lhr-solar/DataAcq-SunlightPCB/Telemetry-PrimaryPCB.pdf

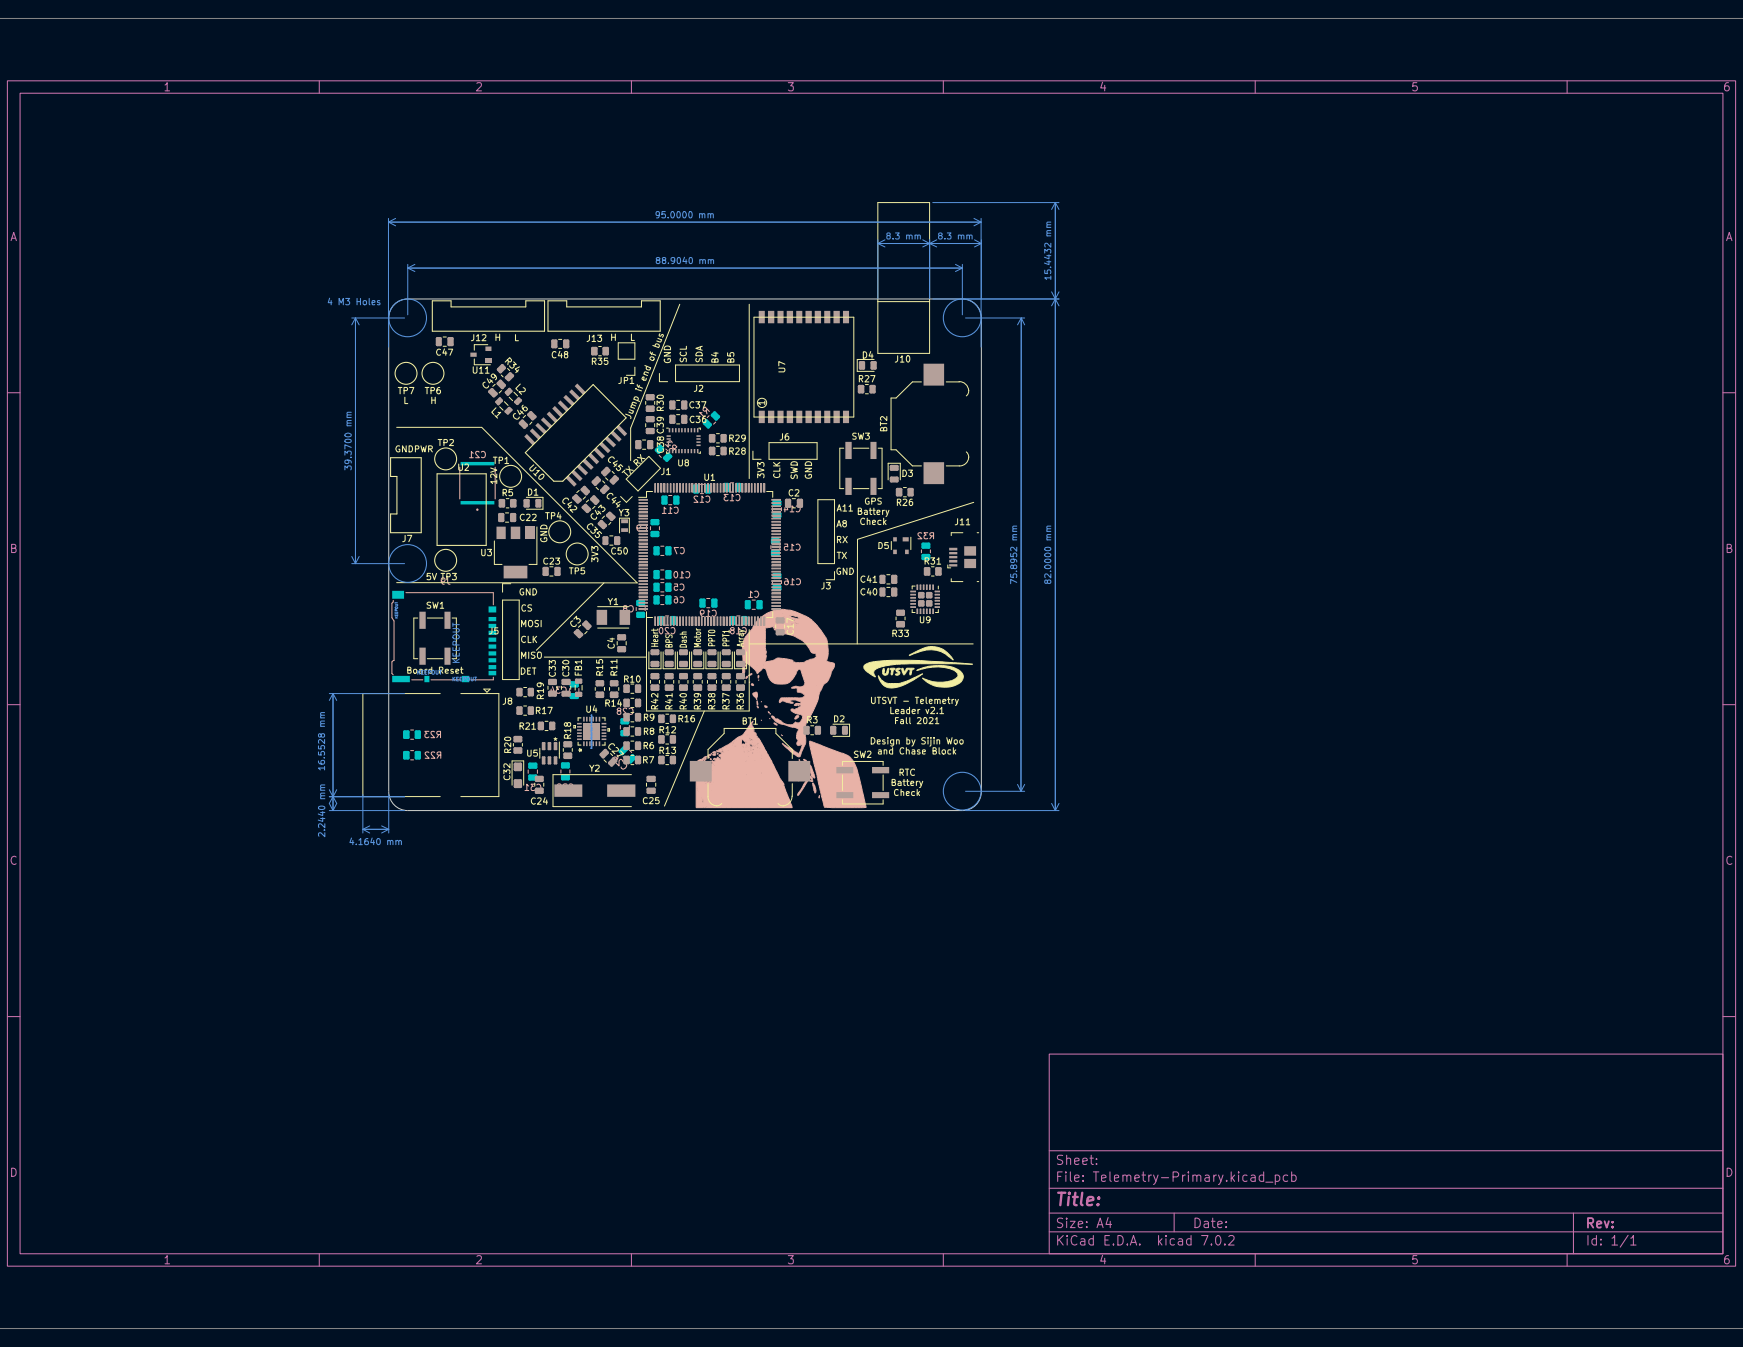
[picture p2: page 1]
