lhr-solar/DataAcq-SunlightPCB/Telemetry-Primary.kicad_pcb

## KiCad design Telemetry-Primary.kicad_pcb (2023-06-17)

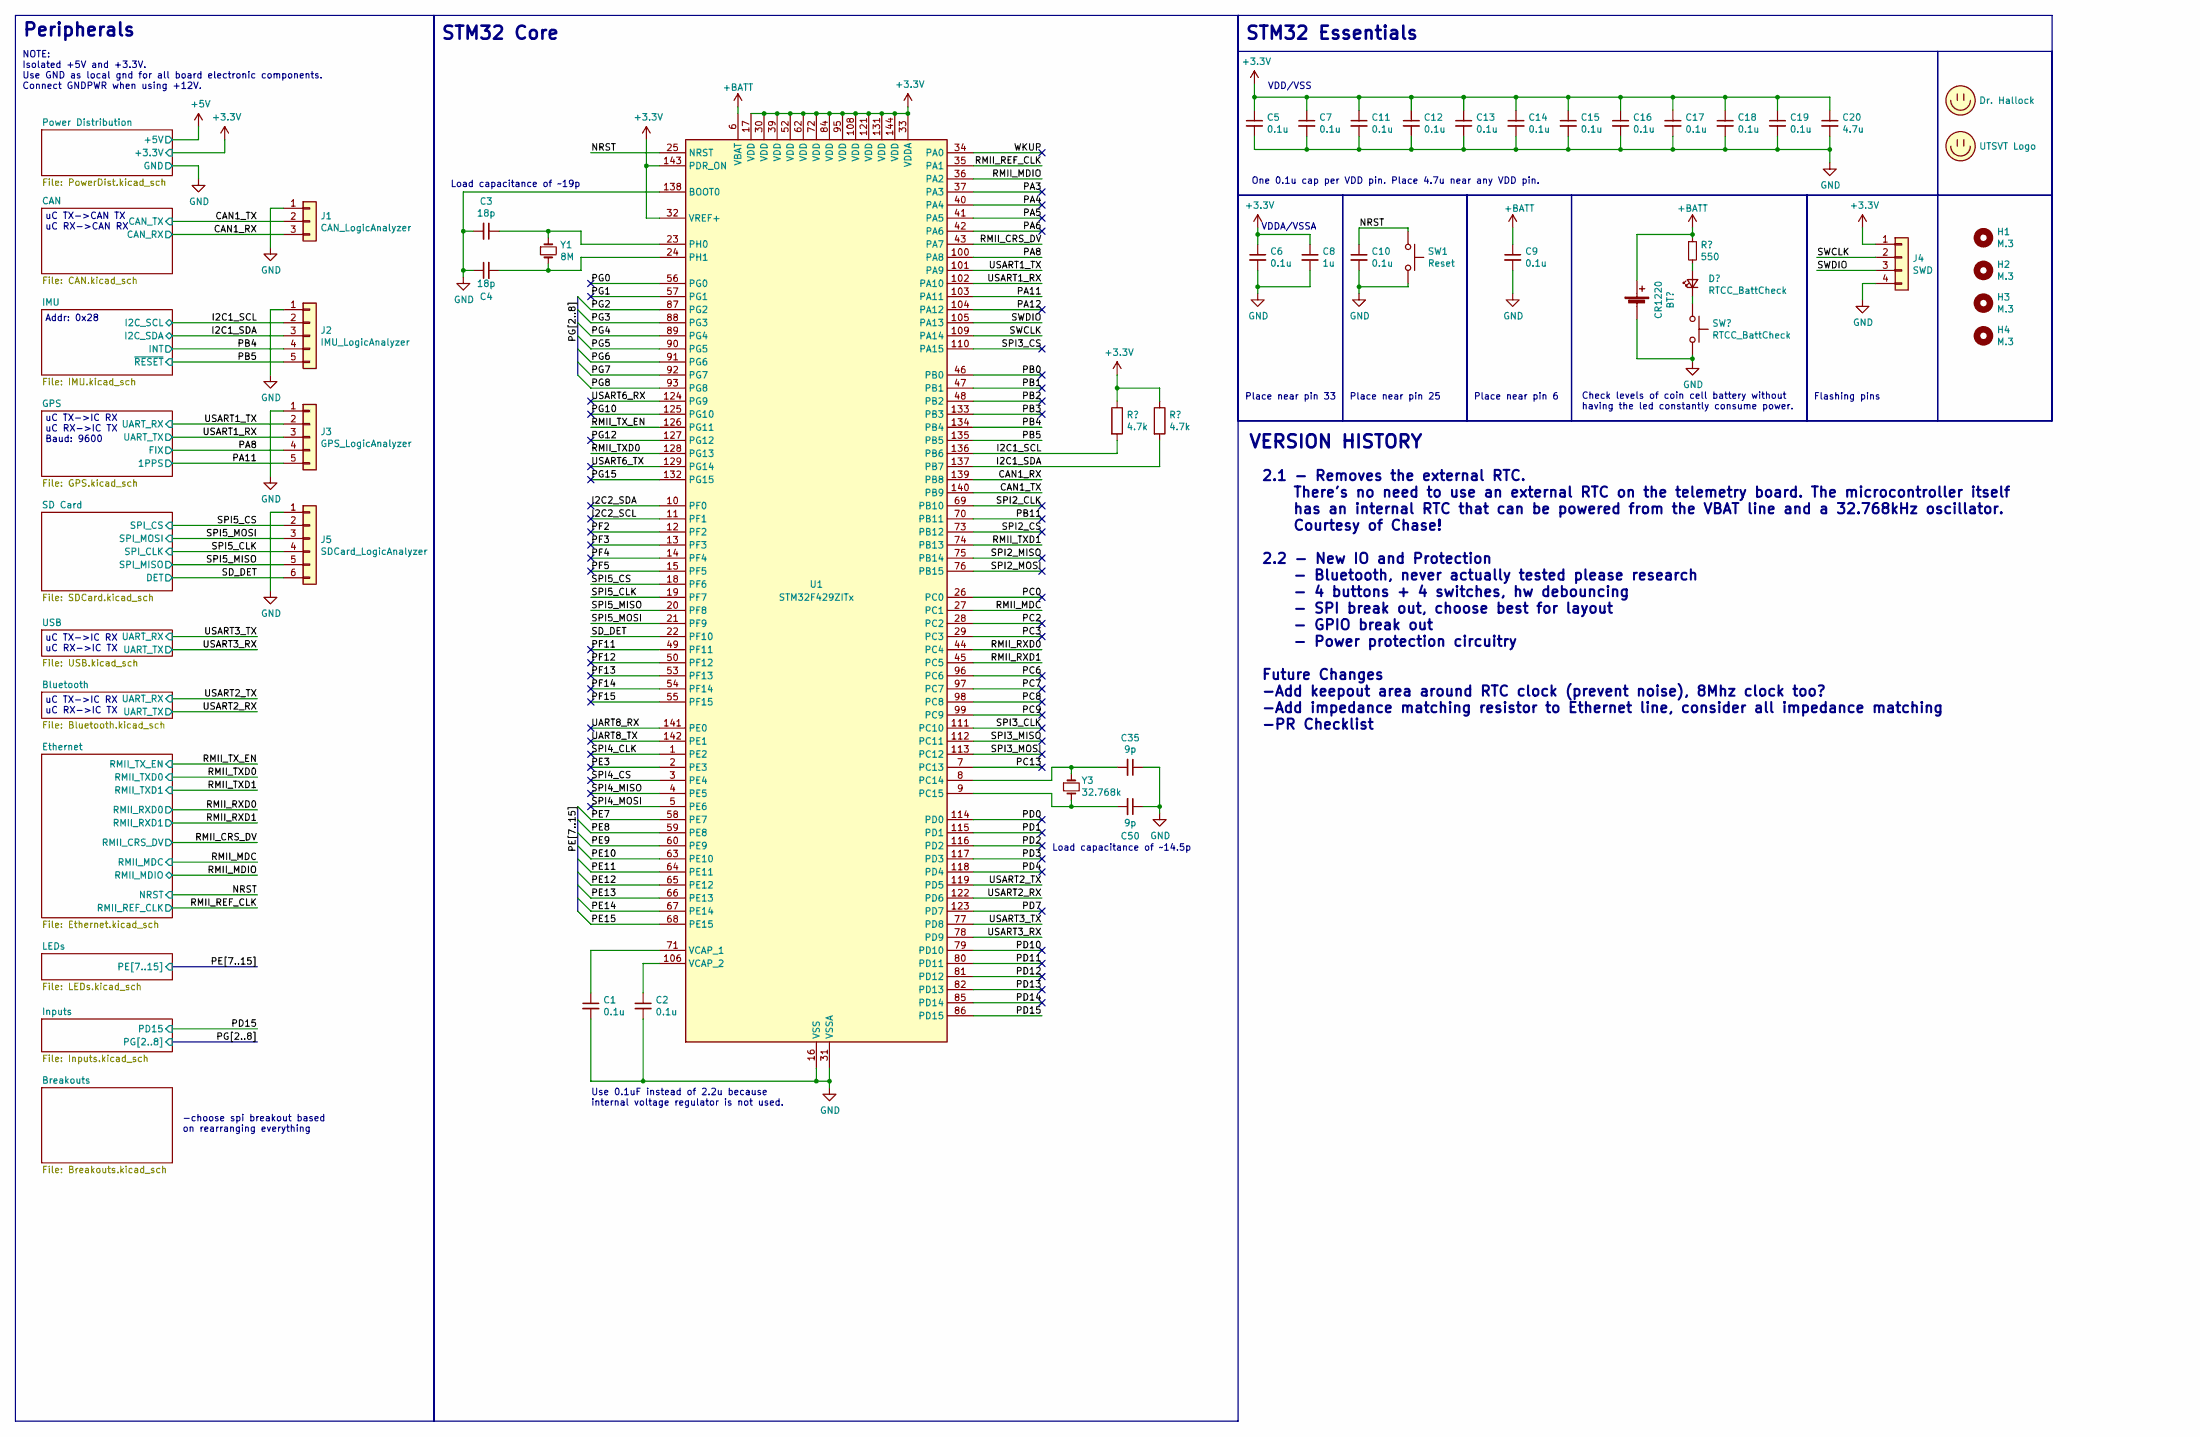
[picture p12: schematic Telemetry-Primary.kicad_sch]

Parts:
BT1: CR1220; BatteryHolder_Keystone_3000_1x12mm
C1, C2, C5, C6, C7, C9, C10, C11, C12, C13, C14, C15, C16, C17, C18, C19: 0.1u; C_0805_2012Metric
C3, C4: 18p; C_0805_2012Metric
C8: 1u; C_0805_2012Metric
C20: 4.7u; C_0805_2012Metric
C35, C50: 9p; C_0805_2012Metric
D2: RTCC_BattCheck; LED_0805_2012Metric
H1, H2, H3, H4: M.3; MountingHole_3mm
J1: CAN_LogicAnalyzer; PinHeader_1x03_P2.54mm_Vertical
J2: IMU_LogicAnalyzer; PinHeader_1x05_P2.54mm_Vertical
J3: GPS_LogicAnalyzer; PinHeader_1x05_P2.54mm_Vertical
J4: SWD; PinHeader_1x04_P2.54mm_Vertical
J5: SDCard_LogicAnalyzer; PinHeader_1x06_P2.54mm_Vertical
LOGO1: Dr. Hallock; Hallock_Image
LOGO2: UTSVT Logo; UTSVT_Logo_Symbol
R1, R2: 4.7k; R_0805_2012Metric
R24: 550; R_0805_2012Metric
SW1: Reset; SW_SPST_B3SL-1002P
SW2: RTCC_BattCheck; SW_SPST_B3SL-1002P
U1: STM32F429ZITx; LQFP-144_20x20mm_P0.5mm
Y1: 8M; Crystal_SMD_TXC_7A-2Pin_5x3.2mm
Y3: 32.768k; Crystal_SMD_2012-2Pin_2.0x1.2mm

Connections:
+3.3V: C5.1, C6.1, C7.1, C8.1, C11.1, C12.1, C13.1, C14.1, C15.1, C16.1, C17.1, C18.1, C19.1, C20.1, J4.1, R1.1, R2.1, U1.17 (VDD), U1.30 (VDD), U1.32 (VREF+), U1.33 (VDDA), U1.39 (VDD), U1.52 (VDD), U1.62 (VDD), U1.72 (VDD), U1.84 (VDD), U1.95 (VDD), U1.108 (VDD), U1.121 (VDD), U1.131 (VDD), U1.143 (PDR_ON), U1.144 (VDD); also elsewhere on the board
/CAN1_RX: J1.3, U1.139 (PB8); also elsewhere on the board
/CAN1_TX: J1.2, U1.140 (PB9); also elsewhere on the board
/I2C1_SCL: J2.2, R1.2, U1.136 (PB6); also elsewhere on the board
/I2C1_SDA: J2.3, R2.2, U1.137 (PB7); also elsewhere on the board
/I2C2_SCL: U1.11 (PF1)
/I2C2_SDA: U1.10 (PF0)
/NRST: C10.1, SW1.1, U1.25 (NRST); also elsewhere on the board
/PA3: U1.37 (PA3)
/PA4: U1.40 (PA4)
/PA5: U1.41 (PA5)
/PA6: U1.42 (PA6)
/PA8: J3.4, U1.100 (PA8); also elsewhere on the board
/PA11: J3.5, U1.103 (PA11); also elsewhere on the board
/PA12: U1.104 (PA12)
/PB0: U1.46 (PB0)
/PB1: U1.47 (PB1)
/PB2: U1.48 (PB2)
/PB3: U1.133 (PB3)
/PB4: J2.4, U1.134 (PB4); also elsewhere on the board
/PB5: J2.5, U1.135 (PB5); also elsewhere on the board
/PB11: U1.70 (PB11)
/PC0: U1.26 (PC0)
/PC2: U1.28 (PC2)
/PC3: U1.29 (PC3)
/PC6: U1.96 (PC6)
/PC7: U1.97 (PC7)
/PC8: U1.98 (PC8)
/PC9: U1.99 (PC9)
/PC13: U1.7 (PC13)
/PD0: U1.114 (PD0)
/PD1: U1.115 (PD1)
/PD2: U1.116 (PD2)
/PD3: U1.117 (PD3)
/PD4: U1.118 (PD4)
/PD7: U1.123 (PD7)
/PD10: U1.79 (PD10)
/PD11: U1.80 (PD11)
/PD12: U1.81 (PD12)
/PD13: U1.82 (PD13)
/PD14: U1.85 (PD14)
/PD15: U1.86 (PD15)
/PE3: U1.2 (PE3)
/PE7: U1.58 (PE7); also elsewhere on the board
/PE8: U1.59 (PE8); also elsewhere on the board
/PE9: U1.60 (PE9); also elsewhere on the board
/PE10: U1.63 (PE10); also elsewhere on the board
/PE11: U1.64 (PE11); also elsewhere on the board
/PE12: U1.65 (PE12); also elsewhere on the board
/PE13: U1.66 (PE13); also elsewhere on the board
/PE14: U1.67 (PE14)
/PE15: U1.68 (PE15)
/PF2: U1.12 (PF2)
/PF3: U1.13 (PF3)
/PF4: U1.14 (PF4)
/PF5: U1.15 (PF5)
/PF11: U1.49 (PF11)
/PF12: U1.50 (PF12)
/PF13: U1.53 (PF13)
/PF14: U1.54 (PF14)
/PF15: U1.55 (PF15)
/PG0: U1.56 (PG0)
/PG1: U1.57 (PG1)
/PG2: U1.87 (PG2)
/PG3: U1.88 (PG3)
/PG4: U1.89 (PG4)
/PG5: U1.90 (PG5)
/PG6: U1.91 (PG6)
/PG7: U1.92 (PG7)
/PG8: U1.93 (PG8)
/PG10: U1.125 (PG10)
/PG12: U1.127 (PG12)
/PG15: U1.132 (PG15)
/RMII_CRS_DV: U1.43 (PA7); also elsewhere on the board
/RMII_MDC: U1.27 (PC1); also elsewhere on the board
/RMII_MDIO: U1.36 (PA2); also elsewhere on the board
/RMII_REF_CLK: U1.35 (PA1); also elsewhere on the board
/RMII_RXD0: U1.44 (PC4); also elsewhere on the board
/RMII_RXD1: U1.45 (PC5); also elsewhere on the board
/RMII_TXD0: U1.128 (PG13); also elsewhere on the board
/RMII_TXD1: U1.74 (PB13); also elsewhere on the board
/RMII_TX_EN: U1.126 (PG11); also elsewhere on the board
/SD_DET: J5.6, U1.22 (PF10); also elsewhere on the board
/SPI2_CLK: U1.69 (PB10)
/SPI2_CS: U1.73 (PB12)
/SPI2_MISO: U1.75 (PB14)
/SPI2_MOSI: U1.76 (PB15)
/SPI3_CLK: U1.111 (PC10)
/SPI3_CS: U1.110 (PA15)
/SPI3_MISO: U1.112 (PC11)
/SPI3_MOSI: U1.113 (PC12)
/SPI4_CLK: U1.1 (PE2)
/SPI4_CS: U1.3 (PE4)
/SPI4_MISO: U1.4 (PE5)
/SPI4_MOSI: U1.5 (PE6)
/SPI5_CLK: J5.4, U1.19 (PF7); also elsewhere on the board
/SPI5_CS: J5.2, U1.18 (PF6); also elsewhere on the board
/SPI5_MISO: J5.5, U1.20 (PF8); also elsewhere on the board
/SPI5_MOSI: J5.3, U1.21 (PF9); also elsewhere on the board
/UART8_RX: U1.141 (PE0)
/UART8_TX: U1.142 (PE1)
/USART1_RX: J3.3, U1.102 (PA10); also elsewhere on the board
/USART1_TX: J3.2, U1.101 (PA9); also elsewhere on the board
/USART2_RX: U1.122 (PD6); also elsewhere on the board
/USART2_TX: U1.119 (PD5); also elsewhere on the board
/USART3_RX: U1.78 (PD9); also elsewhere on the board
/USART3_TX: U1.77 (PD8); also elsewhere on the board
/USART6_RX: U1.124 (PG9)
/USART6_TX: U1.129 (PG14)
/WKUP: U1.34 (PA0)
GND: BT1.2 (-), C1.2, C2.2, C3.2, C4.1, C5.2, C6.2, C7.2, C8.2, C9.2, C10.2, C11.2, C12.2, C13.2, C14.2, C15.2, C16.2, C17.2, C18.2, C19.2, C20.2, C35.1, C50.1, J1.1, J2.1, J3.1, J4.4, J5.1, SW1.2, SW2.2, U1.16 (VSS), U1.31 (VSSA), U1.38 (VSS), U1.51 (VSS), U1.61 (VSS), U1.83 (VSS), U1.94 (VSS), U1.107 (VSS), U1.120 (VSS), U1.130 (VSS), U1.138 (BOOT0); also elsewhere on the board
unnamed: D2.1 (K), SW2.1
unnamed: C35.2, U1.8 (PC14), Y3.1
unnamed: C50.2, U1.9 (PC15), Y3.2
unnamed: C3.1, U1.23 (PH0), Y1.1
unnamed: C4.2, U1.24 (PH1), Y1.2
unnamed: C1.1, U1.71 (VCAP_1)
unnamed: C2.1, U1.106 (VCAP_2)

Notes on the sheet:
2.1 - Removes the external RTC. There's no need to use an external RTC on the telemetry board. The microcontroller itself has an internal RTC that can be powered from the VBAT line and a 32.768kHz oscillator. Courtesy of Chase! 2.2 - New IO and Protection - Bluetooth, never actually tested please r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
Place near pin 25
Load capacitance of ~19p
Place near pin 33
Addr: 0x28
VERSION HISTORY
NOTE: Isolated +5V and +3.3V. Use GND as local gnd for all board electronic components. Connect GNDPWR when using +12V.
STM32 Core
-choose spi breakout based on rearranging everything
Load capacitance of ~14.5p
uC TX->IC RX uC RX->IC TX Baud: 9600
Check levels of coin cell battery without having the led constantly consume power.
VDD/VSS
One 0.1u cap per VDD pin. Place 4.7u near any VDD pin.
Place near pin 6
Use 0.1uF instead of 2.2u because internal voltage regulator is not used.
uC TX->IC RX uC RX->IC TX
VDDA/VSSA
STM32 Essentials
Peripherals
uC TX->CAN TX uC RX->CAN RX
Flashing pins

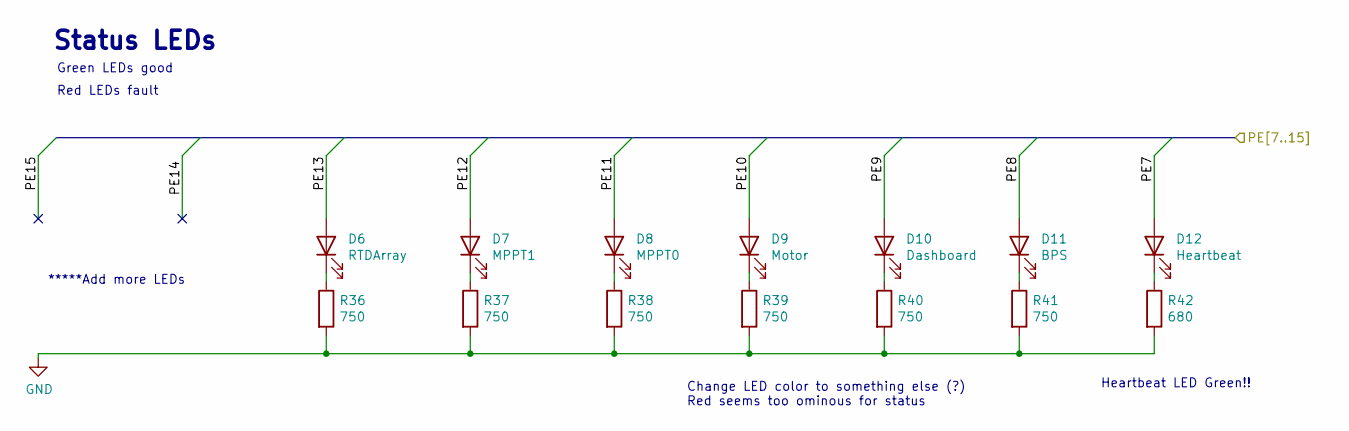
[picture p13: schematic LEDs.kicad_sch]

Parts:
D6: RTDArray; LED_0805_2012Metric
D7: MPPT1; LED_0805_2012Metric
D8: MPPT0; LED_0805_2012Metric
D9: Motor; LED_0805_2012Metric
D10: Dashboard; LED_0805_2012Metric
D11: BPS; LED_0805_2012Metric
D12: Heartbeat; LED_0805_2012Metric
R36, R37, R38, R39, R40, R41: 750; R_0805_2012Metric
R42: 680; R_0805_2012Metric

Connections:
/PE7: D12.2 (A); also elsewhere on the board
/PE8: D11.2 (A); also elsewhere on the board
/PE9: D10.2 (A); also elsewhere on the board
/PE10: D9.2 (A); also elsewhere on the board
/PE11: D8.2 (A); also elsewhere on the board
/PE12: D7.2 (A); also elsewhere on the board
/PE13: D6.2 (A); also elsewhere on the board
GND: R36.2, R37.2, R38.2, R39.2, R40.2, R41.2, R42.2; also elsewhere on the board
unnamed: D6.1 (K), R36.1
unnamed: D7.1 (K), R37.1
unnamed: D8.1 (K), R38.1
unnamed: D9.1 (K), R39.1
unnamed: D10.1 (K), R40.1
unnamed: D11.1 (K), R41.1
unnamed: D12.1 (K), R42.1

Notes on the sheet:
Change LED color to something else (?) Red seems too ominous for status
*****Add more LEDs
Heartbeat LED Green!!
Red LEDs fault
Status LEDs
Green LEDs good

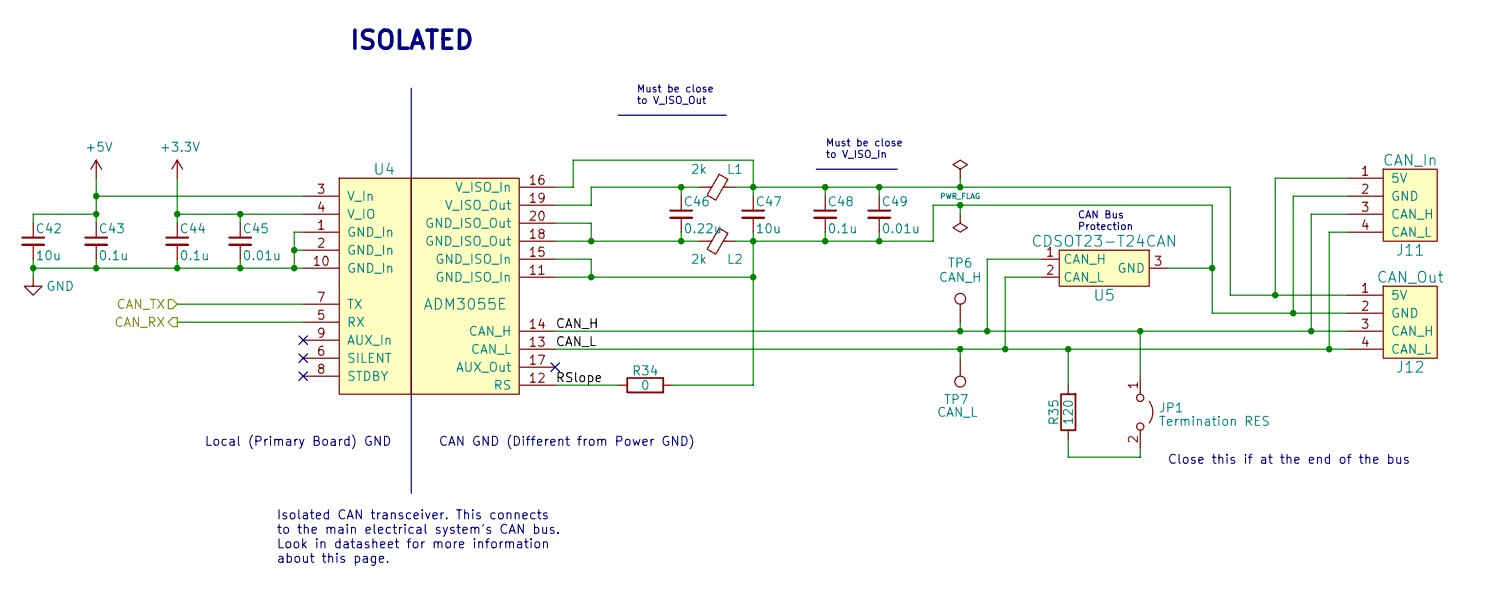
[picture p14: schematic CAN.kicad_sch]

Parts:
C42, C47: 10u; C_0805_2012Metric
C43, C44, C48: 0.1u; C_0805_2012Metric
C45, C49: 0.01u; C_0805_2012Metric
C46: 0.22u; C_0805_2012Metric
J11: CAN_In; Molex_MicroFit3.0_1x4xP3.00mm_PolarizingPeg_Vertical
J12: CAN_Out; Molex_MicroFit3.0_1x4xP3.00mm_PolarizingPeg_Vertical
JP1: Termination RES; PinHeader_1x02_P2.54mm_Vertical
L1, L2: 2k; L_0805_2012Metric
R34: 0; R_0805_2012Metric
R35: 120; R_0805_2012Metric
TP6: CAN_H; TestPoint_Keystone_5005-5009_Compact
TP7: CAN_L; TestPoint_Keystone_5005-5009_Compact
U4: ADM3055E; SOIC-20W_7.5x15.4mm_Pitch1.27mm
U5: CDSOT23-T24CAN; SOT-23W

Connections:
+3.3V: C44.1, C45.1, U4.4 (V_IO); also elsewhere on the board
+5V: C42.1, C43.1, U4.3 (V_In); also elsewhere on the board
/CAN1_RX: U4.5 (RX); also elsewhere on the board
/CAN1_TX: U4.7 (TX); also elsewhere on the board
/CAN/CAN_L: J11.4 (CAN_L), J12.4 (CAN_L), R35.2, TP7.1, U4.13 (CAN_L), U5.2 (CAN_L)
/CAN/RSlope: R34.1, U4.12 (RS)
GND: C42.2, C43.2, C44.2, C45.2, U4.1 (GND_In), U4.2 (GND_In), U4.10 (GND_In); also elsewhere on the board
unnamed: C46.2, L2.2, U4.18 (GND_ISO_Out), U4.20 (GND_ISO_Out)
unnamed: JP1.2 (B), R35.1
unnamed: C46.1, L1.2, U4.19 (V_ISO_Out)

Notes on the sheet:
Local (Primary Board) GND
Must be close to V_ISO_In
Isolated CAN transceiver. This connects to the main electrical system's CAN bus. Look in datasheet for more information about this page.
CAN GND (Different from Power GND)
Must be close to V_ISO_Out
Close this if at the end of the bus
ISOLATED
CAN Bus Protection

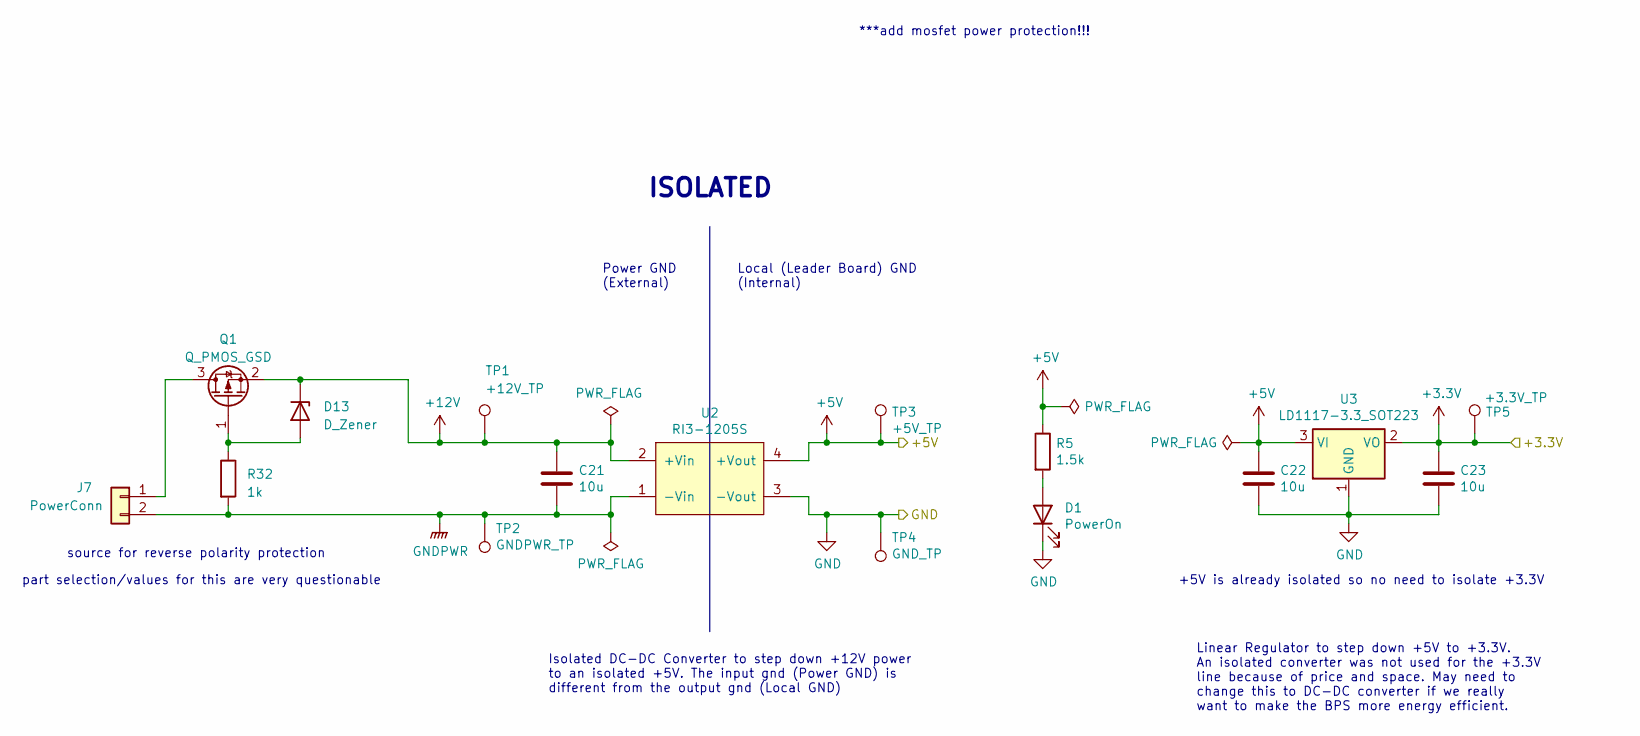
[picture p15: schematic PowerDist.kicad_sch]

Parts:
C21: 10u; C_2220_5750Metric
C22, C23: 10u; C_0805_2012Metric
D1: PowerOn; LED_0805_2012Metric
D13: D_Zener; D_SOD-123F
J7: PowerConn; Molex_MicroFit3.0_1x2xP3.00mm_PolarizingPeg_Vertical
Q1: Q_PMOS_GSD; SuperSOT-3
R5: 1.5k; R_0805_2012Metric
R32: 1k; R_0805_2012Metric
TP1: +12V_TP; TestPoint_Keystone_5005-5009_Compact
TP2: GNDPWR_TP; TestPoint_Keystone_5005-5009_Compact
TP3: +5V_TP; TestPoint_Keystone_5005-5009_Compact
TP4: GND_TP; TestPoint_Keystone_5005-5009_Compact
TP5: +3.3V_TP; TestPoint_Keystone_5005-5009_Compact
U2: RI3-1205S; RI3_DC_Converter
U3: LD1117-3.3_SOT223; SOT-223-3_TabPin2

Connections:
+3.3V: C23.1, TP5.1, U3.2 (VO); also elsewhere on the board
+5V: C22.1, R5.1, TP3.1, U2.4 (+Vout), U3.3 (VI); also elsewhere on the board
+12V: C21.1, D13.1 (K), J7.1, Q1.2 (S), Q1.3 (D), TP1.1, U2.2 (+Vin)
GND: C22.2, C23.2, D1.1 (K), TP4.1, U2.3 (-Vout), U3.1 (GND); also elsewhere on the board
GNDPWR: C21.2, J7.2, R32.2, TP2.1, U2.1 (-Vin)
unnamed: D1.2 (A), R5.2
unnamed: D13.2 (A), Q1.1 (G), R32.1

Notes on the sheet:
***add mosfet power protection!!!
Power GND (External)
Linear Regulator to step down +5V to +3.3V. An isolated converter was not used for the +3.3V line because of price and space. May need to change this to DC-DC converter if we really want to make the BPS more energy efficient.
Isolated DC-DC Converter to step down +12V power to an isolated +5V. The input gnd (Power GND) is different from the output gnd (Local GND)
Local (Leader Board) GND (Internal)
ISOLATED
part selection/values for this are very questionable
source for reverse polarity protection
+5V is already isolated so no need to isolate +3.3V

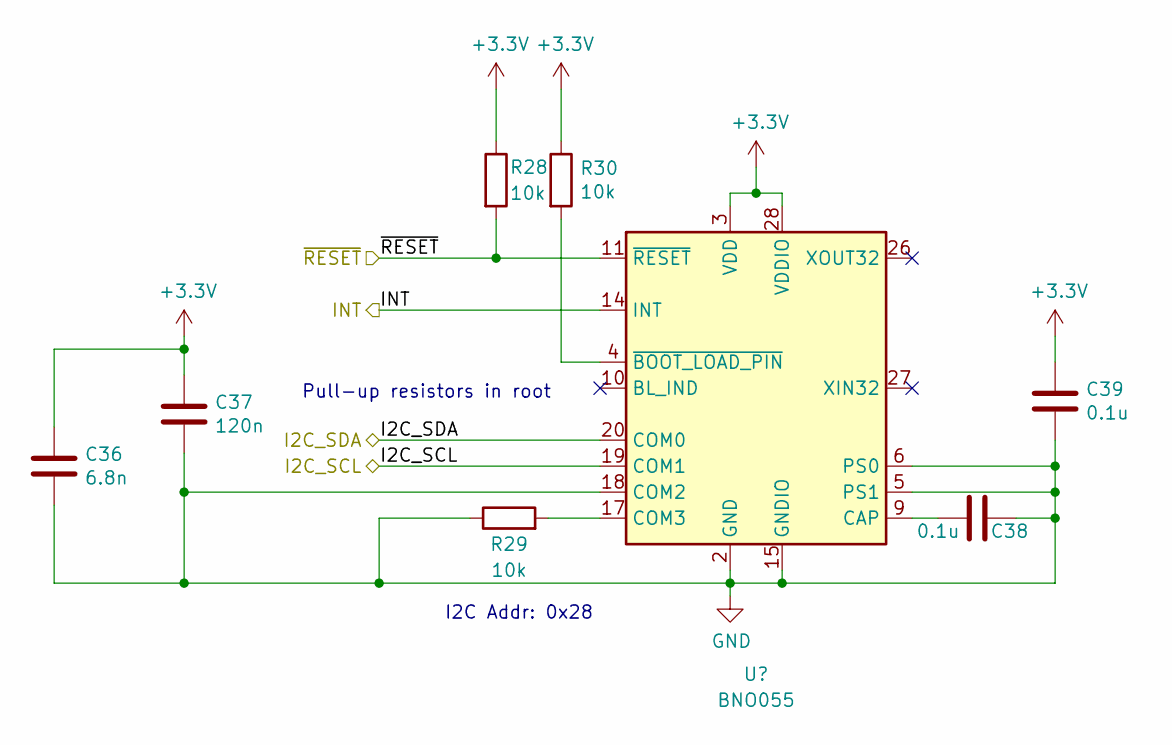
[picture p16: schematic IMU.kicad_sch]

Parts:
C36: 6.8n; C_0805_2012Metric
C37: 120n; C_0805_2012Metric
C38, C39: 0.1u; C_0805_2012Metric
R28, R29, R30: 10k; R_0805_2012Metric
U6: BNO055; LGA-28_5.2x3.8mm_P0.5mm

Connections:
+3.3V: C36.1, C37.1, C39.1, R28.1, R30.1, U6.3 (VDD), U6.28 (VDDIO); also elsewhere on the board
/I2C1_SCL: U6.19 (COM1); also elsewhere on the board
/I2C1_SDA: U6.20 (COM0); also elsewhere on the board
/PB4: U6.14 (INT); also elsewhere on the board
/PB5: R28.2, U6.11 (~RESET); also elsewhere on the board
GND: C36.2, C37.2, C38.1, C39.2, R29.1, U6.2 (GND), U6.5 (PS1), U6.6 (PS0), U6.15 (GNDIO), U6.16 (GNDIO), U6.18 (COM2), U6.25 (GNDIO); also elsewhere on the board
unnamed: C38.2, U6.9 (CAP)
unnamed: R29.2, U6.17 (COM3)
unnamed: R30.2, U6.4 (~BOOT_LOAD_PIN)

Notes on the sheet:
Pull-up resistors in root
I2C Addr: 0x28

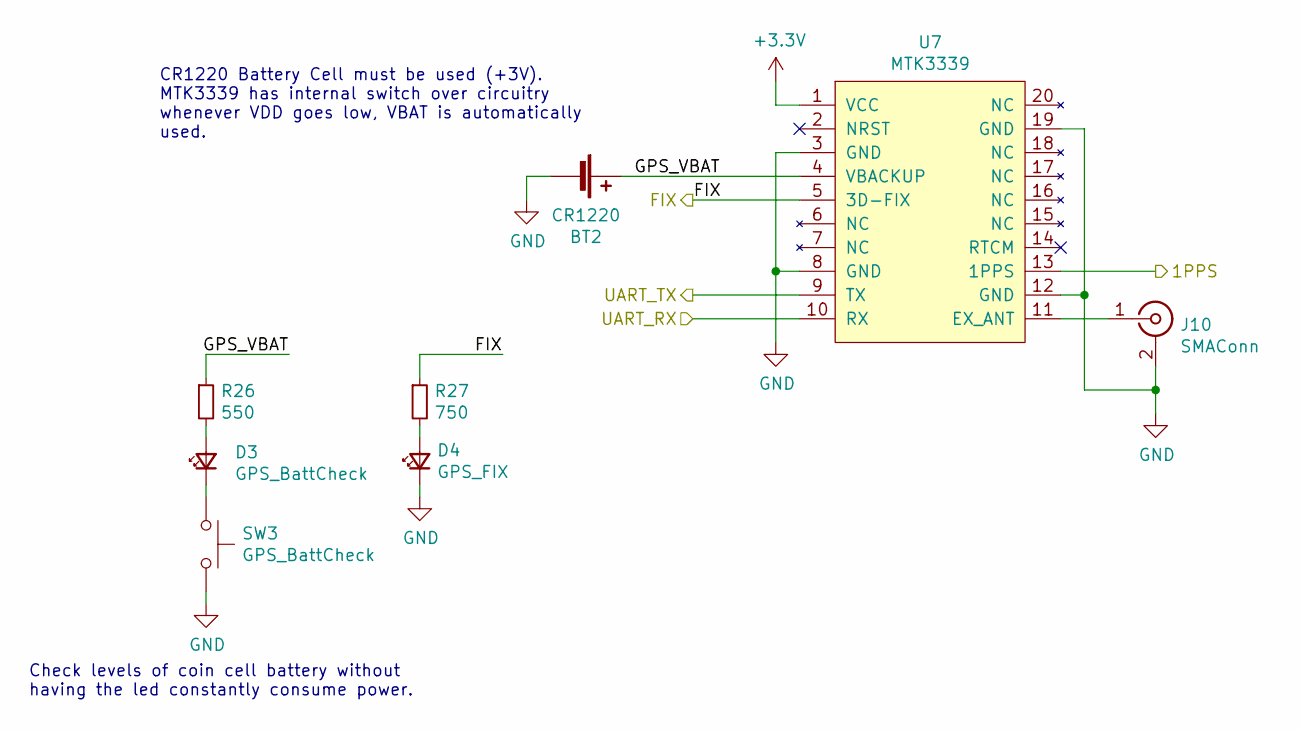
[picture p17: schematic GPS.kicad_sch]

Parts:
BT2: CR1220; BatteryHolder_Keystone_3000_1x12mm
D3: GPS_BattCheck; LED_0805_2012Metric
D4: GPS_FIX; LED_0805_2012Metric
J10: SMAConn; SMA_Amphenol_132203-12_Horizontal
R26: 550; R_0805_2012Metric
R27: 750; R_0805_2012Metric
SW3: GPS_BattCheck; SW_SPST_B3SL-1002P
U7: MTK3339; FGPMMOPA6H

Connections:
+3.3V: U7.1 (VCC); also elsewhere on the board
/GPS/GPS_VBAT: BT2.1 (+), R26.1, U7.4 (VBACKUP)
/PA8: R27.1, U7.5 (3D-FIX); also elsewhere on the board
/PA11: U7.13 (1PPS); also elsewhere on the board
/USART1_RX: U7.9 (TX); also elsewhere on the board
/USART1_TX: U7.10 (RX); also elsewhere on the board
GND: BT2.2 (-), D4.1 (K), J10.2 (Ext), SW3.2, U7.3 (GND), U7.8 (GND), U7.12 (GND), U7.19 (GND); also elsewhere on the board
unnamed: D3.2 (A), R26.2
unnamed: D3.1 (K), SW3.1
unnamed: D4.2 (A), R27.2
unnamed: J10.1 (In), U7.11 (EX_ANT)

Notes on the sheet:
Check levels of coin cell battery without having the led constantly consume power.
CR1220 Battery Cell must be used (+3V). MTK3339 has internal switch over circuitry whenever VDD goes low, VBAT is automatically used.

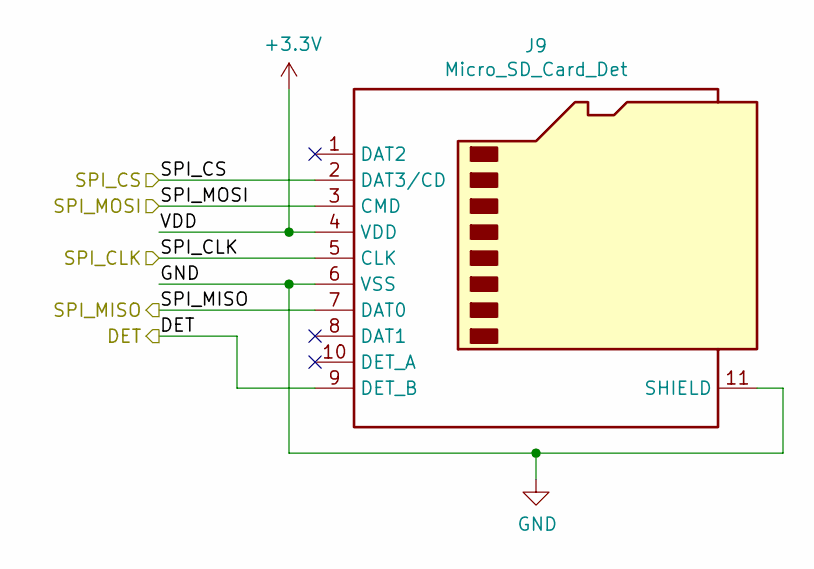
[picture p18: schematic SDCard.kicad_sch]

Parts:
J9: Micro_SD_Card_Det; microSD_HC_Hirose_DM3AT-SF-PEJM5

Connections:
+3.3V: J9.4 (VDD); also elsewhere on the board
/SD_DET: J9.9 (DET_B); also elsewhere on the board
/SPI5_CLK: J9.5 (CLK); also elsewhere on the board
/SPI5_CS: J9.2 (DAT3/CD); also elsewhere on the board
/SPI5_MISO: J9.7 (DAT0); also elsewhere on the board
/SPI5_MOSI: J9.3 (CMD); also elsewhere on the board
GND: J9.6 (VSS), J9.11 (SHIELD); also elsewhere on the board

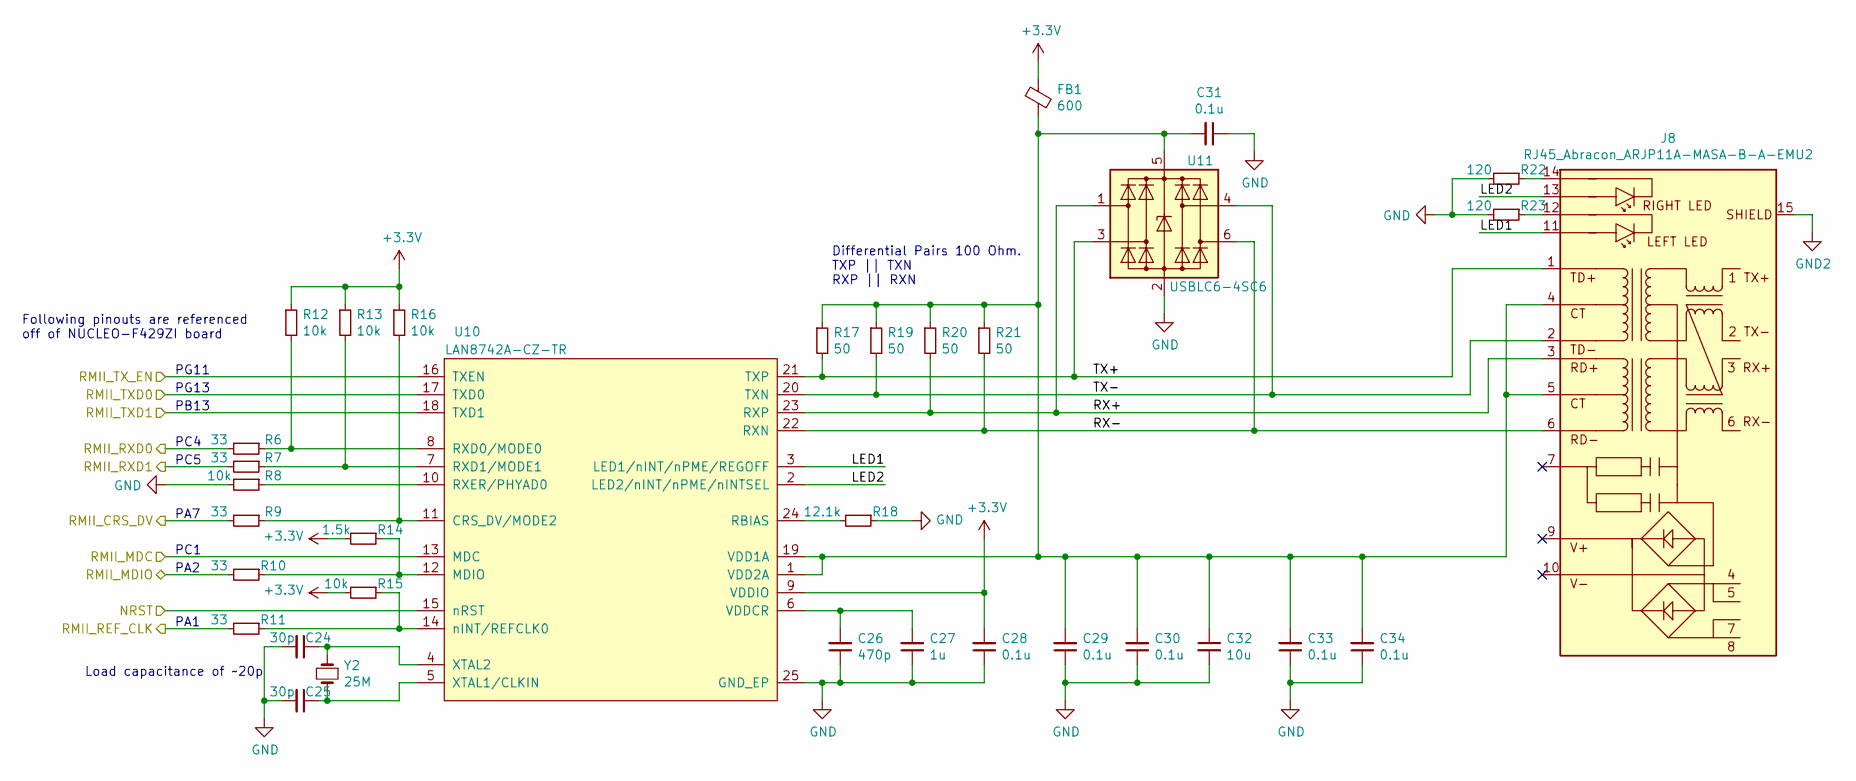
[picture p19: schematic Ethernet.kicad_sch]

Parts:
C24, C25: 30p; C_0805_2012Metric
C26: 470p; C_0805_2012Metric
C27: 1u; C_0805_2012Metric
C28, C29, C30, C31, C33, C34: 0.1u; C_0805_2012Metric
C32: 10u; CP_EIA-3216-18_Kemet-A
FB1: 600; L_0805_2012Metric
J8: RJ45_Abracon_ARJP11A-MASA-B-A-EMU2; RJ45_Abracon_ARJP11A-MA_Horizontal
R6, R7, R9, R10, R11: 33; R_0805_2012Metric
R8, R12, R13, R15, R16: 10k; R_0805_2012Metric
R14: 1.5k; R_0805_2012Metric
R17, R19, R20, R21: 50; R_0805_2012Metric
R18: 12.1k; R_0805_2012Metric
R22, R23: 120; R_0805_2012Metric
U10: LAN8742A-CZ-TR; LAN8742AI-CZ-TR
U11: USBLC6-4SC6; SOT-23-6
Y2: 25M; Crystal_SMD_HC49-SD

Connections:
+3.3V: C28.2, FB1.1, R12.1, R13.1, R14.2, R15.2, R16.1, U10.9 (VDDIO); also elsewhere on the board
/Ethernet/LED1: J8.11 (LLED+), U10.3 (LED1/nINT/nPME/REGOFF)
/Ethernet/LED2: J8.13 (RLED+), U10.2 (LED2/nINT/nPME/nINTSEL)
/Ethernet/RX+: J8.3 (RD+), R20.2, U10.23 (RXP), U11.1 (I/O1)
/Ethernet/RX-: J8.6 (RD-), R21.2, U10.22 (RXN), U11.6 (I/O4)
/Ethernet/TX+: J8.1 (TD+), R17.2, U10.21 (TXP), U11.3 (I/O2)
/Ethernet/TX-: J8.2 (TD-), R19.2, U10.20 (TXN), U11.4 (I/O3)
/NRST: U10.15 (nRST); also elsewhere on the board
/RMII_CRS_DV: R9.2; also elsewhere on the board
/RMII_MDC: U10.13 (MDC); also elsewhere on the board
/RMII_MDIO: R10.2; also elsewhere on the board
/RMII_REF_CLK: R11.2; also elsewhere on the board
/RMII_RXD0: R6.2; also elsewhere on the board
/RMII_RXD1: R7.2; also elsewhere on the board
/RMII_TXD0: U10.17 (TXD0); also elsewhere on the board
/RMII_TXD1: U10.18 (TXD1); also elsewhere on the board
/RMII_TX_EN: U10.16 (TXEN); also elsewhere on the board
GND: C24.2, C25.2, C26.1, C27.1, C28.1, C29.1, C30.1, C31.1, C32.2, C33.1, C34.1, R8.2, R18.1, R22.2, R23.2, U10.25 (GND_EP), U11.2 (GND); also elsewhere on the board
GND2: J8.15 (SHIELD)
unnamed: J8.12 (LLED-), R23.1
unnamed: J8.14 (RLED-), R22.1
unnamed: R9.1, R16.2, U10.11 (CRS_DV/MODE2)
unnamed: R10.1, R14.1, U10.12 (MDIO)
unnamed: R18.2, U10.24 (RBIAS)
unnamed: R6.1, R12.2, U10.8 (RXD0/MODE0)
unnamed: R7.1, R13.2, U10.7 (RXD1/MODE1)
unnamed: R8.1, U10.10 (RXER/PHYAD0)
unnamed: C29.2, C30.2, C31.2, C32.1, C33.2, C34.2, FB1.2, J8.4 (CT), J8.5 (CT), R17.1, R19.1, R20.1, R21.1, U10.1 (VDD2A), U10.19 (VDD1A), U11.5 (VBUS)
unnamed: C26.2, C27.2, U10.6 (VDDCR)
unnamed: C25.1, U10.5 (XTAL1/CLKIN), Y2.2
unnamed: C24.1, U10.4 (XTAL2), Y2.1
unnamed: R11.1, R15.1, U10.14 (nINT/REFCLK0)

Notes on the sheet:
Differential Pairs 100 Ohm. TXP || TXN RXP || RXN
PA1
Load capacitance of ~20p
Following pinouts are referenced off of NUCLEO-F429ZI board
PA7
PG13
PC4
PB13
PC1
PA2
PG11
PC5

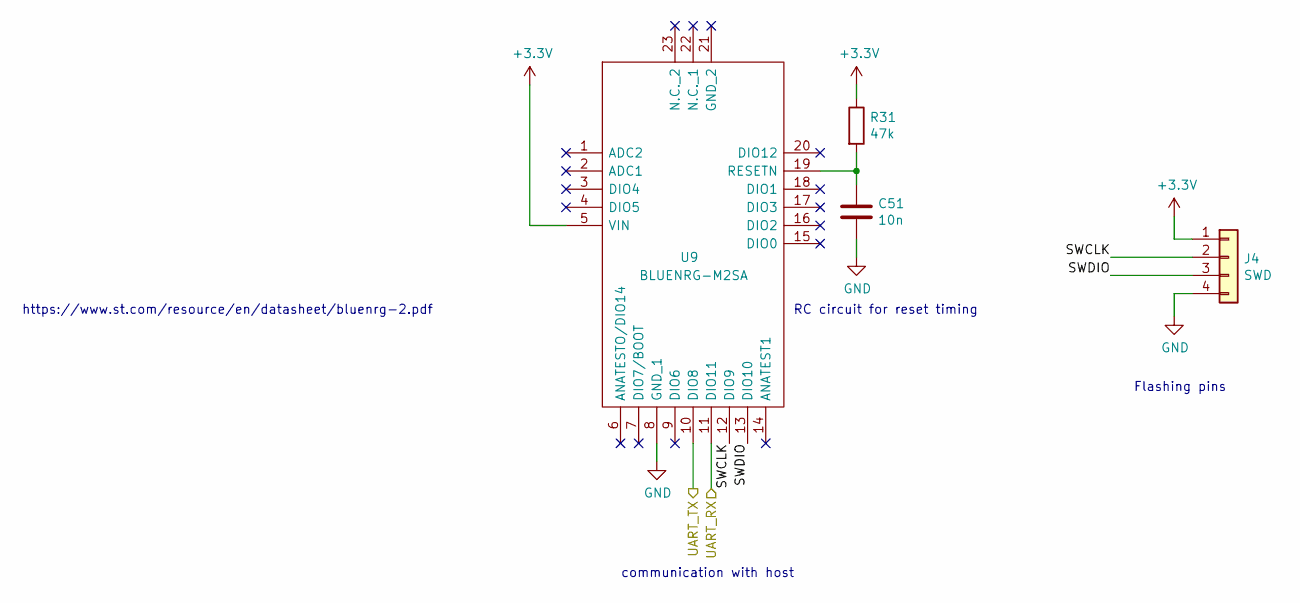
[picture p20: schematic Bluetooth.kicad_sch]

Parts:
C51: 10n; C_0805_2012Metric
J4: SWD; PinHeader_1x04_P2.54mm_Vertical
R31: 47k; R_0805_2012Metric
U9: BLUENRG-M2SA; BLUENRGM2SA; Mouser Part Number 511-BLUENRG-M2SA

Connections:
+3.3V: J4.1, R31.1, U9.5 (VIN); also elsewhere on the board
/USART2_RX: U9.10 (DIO8); also elsewhere on the board
/USART2_TX: U9.11 (DIO11); also elsewhere on the board
GND: C51.2, J4.4, U9.8 (GND_1); also elsewhere on the board
unnamed: C51.1, R31.2, U9.19 (RESETN)

Notes on the sheet:
RC circuit for reset timing
communication with host
https://www.st.com/resource/en/datasheet/bluenrg-2.pdf
Flashing pins

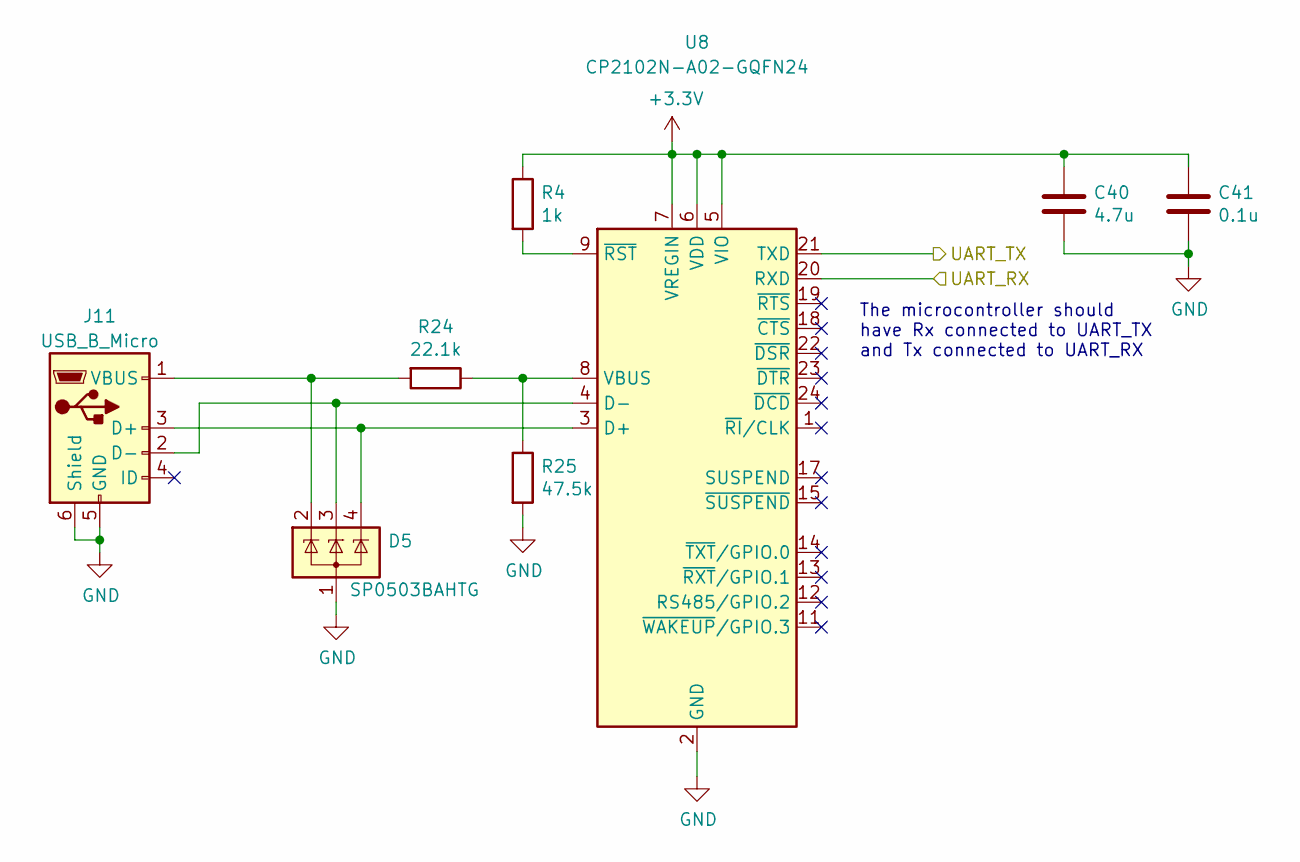
[picture p21: schematic USB.kicad_sch]

Parts:
C40: 4.7u; C_0805_2012Metric
C41: 0.1u; C_0805_2012Metric
D5: SP0503BAHTG; SOT-143
J11: USB_B_Micro; USB_Micro-B_Molex-105017-0001
R4: 1k; R_0805_2012Metric
R24: 22.1k; R_0805_2012Metric
R25: 47.5k; R_0805_2012Metric
U8: CP2102N-A02-GQFN24; QFN-24-1EP_4x4mm_P0.5mm_EP2.6x2.6mm

Connections:
+3.3V: C40.1, C41.1, R4.1, U8.5 (VIO), U8.6 (VDD), U8.7 (VREGIN); also elsewhere on the board
/CAN/CAN_L: J11.4 (CAN_L); also elsewhere on the board
/USART3_RX: U8.21 (TXD); also elsewhere on the board
/USART3_TX: U8.20 (RXD); also elsewhere on the board
GND: C40.2, C41.2, D5.1 (A), J11.5 (GND), J11.6 (Shield), R25.2, U8.2 (GND), U8.25 (GND); also elsewhere on the board
unnamed: R4.2, U8.9 (~RST)

Notes on the sheet:
The microcontroller should have Rx connected to UART_TX and Tx connected to UART_RX

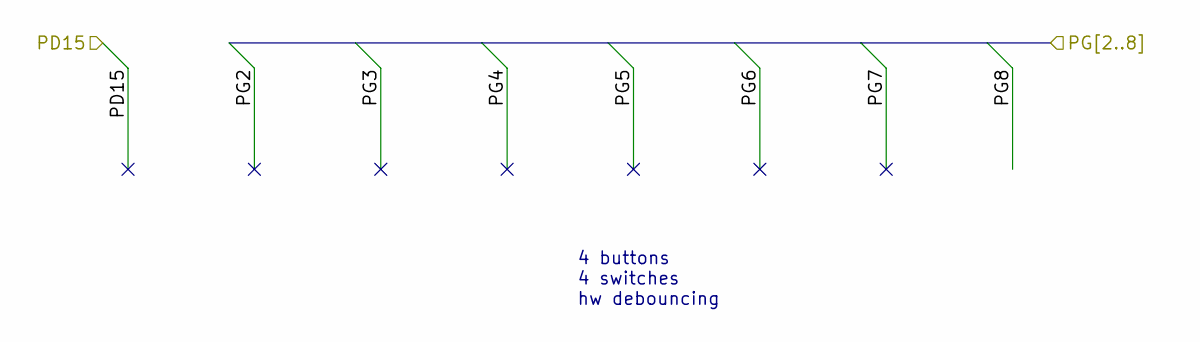
[picture p22: schematic Inputs.kicad_sch]

Notes on the sheet:
4 buttons 4 switches hw debouncing

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
