lhr-solar/DataAcq-SunlightPCB/Telemetry-Primary.kicad_pcb

## KiCad design Telemetry-Primary.kicad_pcb (continued)

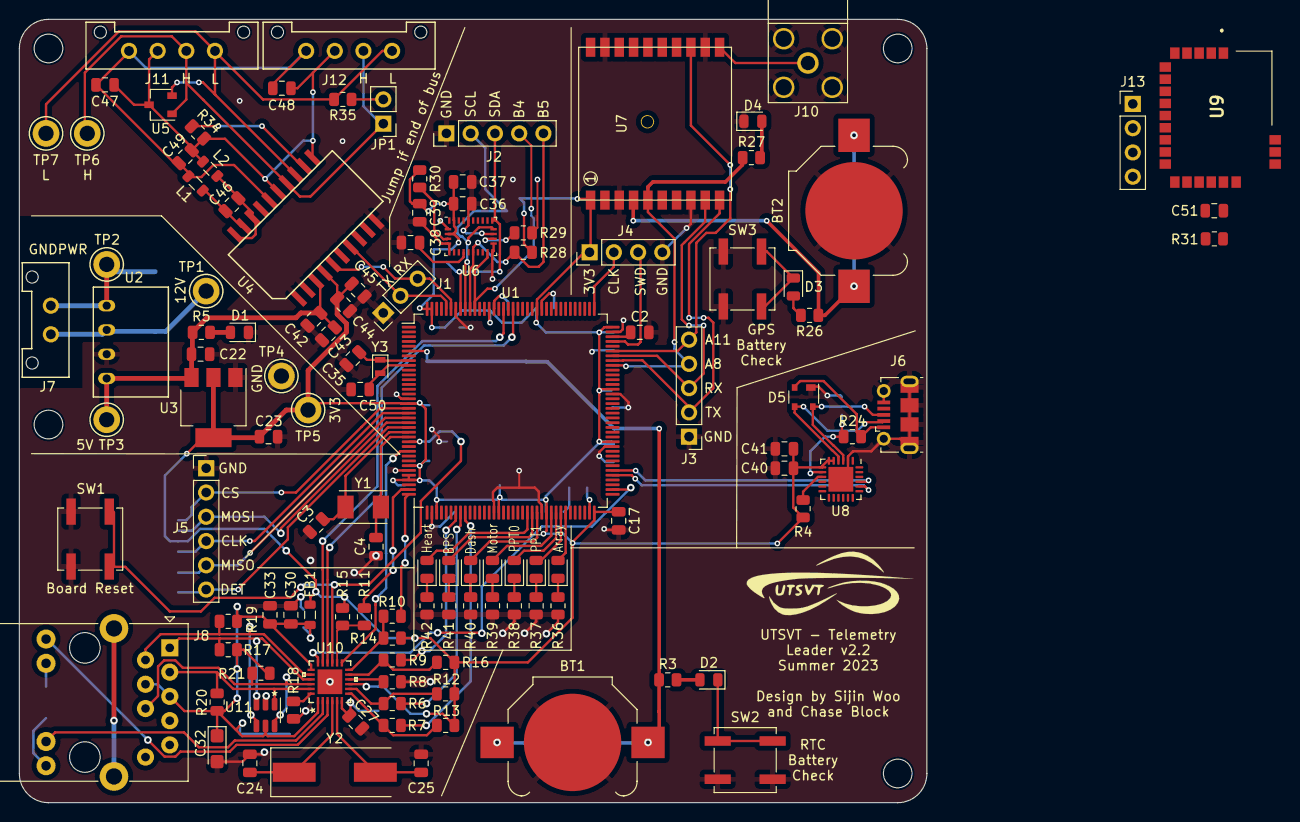
[picture p23: board Telemetry-Primary.kicad_pcb from above]

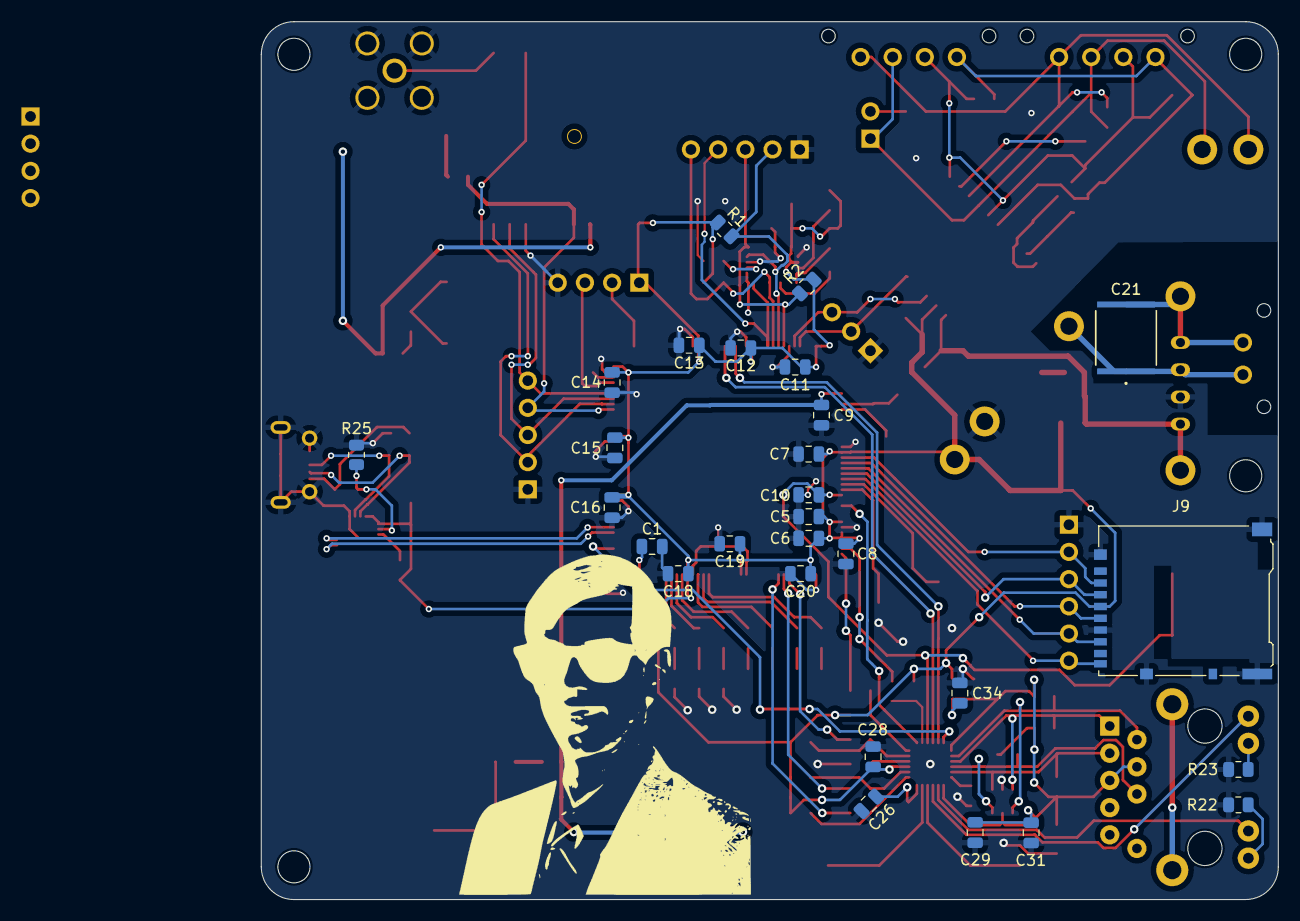
[picture p24: board Telemetry-Primary.kicad_pcb from below]

Board: 2 copper layers, 95.0 x 82.0 mm, 152 parts (29 on the bottom side), 103 nets.

Other parts of the board:
J6: USB_B_Micro; USB_Micro-B_Molex-105017-0001
J13: SWD; PinHeader_1x04_P2.54mm_Vertical
R3: 550; R_0805_2012Metric

Their connections:
+3.3V: J13.1; also elsewhere on the board
GND: J6.5 (GND), J6.6 (Shield), J13.4; also elsewhere on the board
