lhr-solar/DataAcq-SunlightPCB/(commit log)

2020-08-02 Set up for own repo
    [BOM.csv, BPS-Nucleo.kicad_pcb, BPS-Nucleo.sch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]
2020-09-05 Changes name of molex Power and CAN connectors to be more meaningful (#1)
    [TelemetryBoard.sch]
2020-09-15 Updates project name and submodule
    [Telemetry-Primary.kicad_pcb, Telemetry-Primary.sch]
2020-09-19 Adds new telemetry board schematics. Still need to place GPS and Ethernet and some main uC essentials
    [CAN.sch, Ethernet.sch, GPS.sch, IMU.sch, PowerDist.sch, RTCC.sch, SDCard.sch, Telemetry-Primary.sch]
2020-09-19 Updates common component library
    [Ethernet.sch, Telemetry-Primary.sch]
2020-09-19 Adds ethernet schematics
    [Ethernet.sch]
2020-09-19 Adds GPS module to common library
    [Ethernet.sch, GPS.sch, PowerDist.sch, Telemetry-Primary.sch]
2020-09-19 Adds connects all modules except for LEDs in schematics
    [CAN.sch, Ethernet.sch, GPS.sch, IMU.sch, LEDs.sch, PowerDist.sch, RTCC.sch, SDCard.sch]
2020-09-19 Adds logic analyzer points and LEDs
    [GPS.sch, LEDs.sch, PowerDist.sch, RTCC.sch, Telemetry-Primary.sch]
2020-09-19 Initial layout of the Telemtry board.
    The ethernet interface needs more work.
    [CAN.sch, Ethernet.sch, GPS.sch, IMU.sch, LEDs.sch, PowerDist.sch, RTCC.sch, SDCard.sch]
2020-09-26 Lay out the Telemetry board.
    This is the initial draft of the Telemetry board layout. A few
    debugging pins changed (on the SD card) for easier routing.
    There is still some uncertainty with regard to the routing of the
    Ethernet traces. According to my calculations, the differential
    impedence between the RX+/- traces and the TX+/- traces is around
    150R, which is 50% higher than one source was recommending. I am
    uncertain how to reduce this though, and I am unclear as to how
    much this will affect performance, especially when the traces
    cover such a short distance.
    [Ethernet.sch, IMU.sch, RTCC.sch, SDCard.sch, Telemetry-Primary.kicad_pcb, Telemetry-Primary.sch, USB.sch]
2020-10-03 Makes mounting hole text invisible and updates title
    [Telemetry-Primary.kicad_pcb]
2020-10-03 Fix routing near crystal.
    [CAN.sch, Ethernet.sch, GPS.sch, IMU.sch, PowerDist.sch, RTCC.sch, Telemetry-Primary.kicad_pcb, Telemetry-Primary.sch]
2020-10-03 Telemetry v2.0 (#2)
    * Updates project name and submodule
    * Adds new telemetry board schematics. Still need to place GPS and Ethernet and some main uC essentials
    * Updates common component library
    * Adds ethernet schematics
    * Adds GPS module to common library
    * Updates common submodule to include GPS
    * Adds connects all modules except for LEDs in schematics
    * Adds logic analyzer points and LEDs
    * Initial layout of the Telemtry board.
    * Lay out the Telemetry board.
    There is still some uncertainty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
    [CAN.sch, Ethernet.sch, GPS.sch, IMU.sch, LEDs.sch, PowerDist.sch, RTCC.sch, SDCard.sch]
2020-10-07 Update schematic symbol details with ordering info.
    [CAN.sch, Ethernet.sch, GPS.sch, IMU.sch, LEDs.sch, PowerDist.sch, RTCC.sch, SDCard.sch]
2023-05-22 kicad 7, fixed 3d models, symbols, submodules
    i now realize chase has a v2.1 branch..
    [CAN.kicad_sch, Ethernet.kicad_sch, GPS.kicad_sch, IMU.kicad_sch, LEDs.kicad_sch, PowerDist.kicad_sch, RTCC.kicad_sch, SDCard.kicad_sch]
2023-05-22 merged v2.1 changes
    removes external RTC, cleaned up big errors, only minor warnings remain
    [CAN.kicad_sch, Ethernet.kicad_sch, GPS.kicad_sch, IMU.kicad_sch, PowerDist.kicad_sch, RTCC.kicad_sch, RTCC.sch, SDCard.kicad_sch]
2023-05-22 cleaner, still needs full checklisting
    [CAN.kicad_sch, Ethernet.kicad_sch, GPS.kicad_sch, IMU.kicad_sch, PowerDist.kicad_sch, SDCard.kicad_sch, Telemetry-Primary.kicad_pcb, Telemetry-Primary.kicad_sch]
2023-05-23 neatening things up
    [GPS.kicad_sch, SDCard.kicad_sch, Telemetry-Primary.kicad_pcb]
2023-05-26 bom, gerbers, edge cuts, footprint verification
    [CAN.kicad_sch, Ethernet.kicad_sch, GPS.kicad_sch, IMU.kicad_sch, LEDs.kicad_sch, PowerDist.kicad_sch, SDCard.kicad_sch, Telemetry-Primary.kicad_pcb]
2023-05-26 sch and pcb pdfs
    [Telemetry-Primary.kicad_pcb, Telemetry-Primary.kicad_sch]
2023-05-29 schematic organization
    [Telemetry-Primary.kicad_pcb, Telemetry-Primary.kicad_sch]
2023-05-29 rename pdfs, ibom
    [Telemetry-Primary.kicad_pcb]
2023-05-30 added connector types
2023-06-12 bluetooth schematic additions
    [Bluetooth.kicad_sch, Breakouts.kicad_sch, CAN.kicad_sch, Ethernet.kicad_sch, IMU.kicad_sch, Inputs.kicad_sch, LEDs.kicad_sch, SDCard.kicad_sch]
2023-06-12 began input/breakout changes
    [Inputs.kicad_sch, LEDs.kicad_sch, PowerDist.kicad_sch, Telemetry-Primary.kicad_pcb, Telemetry-Primary.kicad_sch]
2023-06-17 new bt module + preliminary reverse protection
    [Bluetooth.kicad_sch, Ethernet.kicad_sch, Inputs.kicad_sch, PowerDist.kicad_sch, Telemetry-Primary.kicad_pcb, Telemetry-Primary.kicad_sch]
2023-06-17 basic inputs
    [Bluetooth.kicad_sch, GPS.kicad_sch, Inputs.kicad_sch, PowerDist.kicad_sch, Telemetry-Primary.kicad_sch]
2023-06-24 add power ports to power dist
2023-06-24 Revert "add power ports to power dist"
    This reverts commit 2e61877daa8ca3bb2eb3a68fbb2dd0a708ef5124.
